G4FEV/SDRUno-Smart-Switch/README.md

<meta name='keywords' content='G4FEV, SDRUno, SDRplay'>

# SDRuno SMART-SWITCH

## David Whitty G4FEV

<i>Last edit 25 August 2020.</i>

This software is given freely for non-commercial use with no guarantee given or implied.
SDRUno is a product of SDRPlay Ltd with which the author has no connection other than as a satisfied customer.

<a href="https://github.com/G4FEV/SDRUno-Smart-Switch/archive/master.zip"><font size="2"> DOWNLOAD SMART-SWITCH PROJECT as zip</font></a>

## What is this?

An Arduino is used to detect the frequency SDRuno is tuned to.
The frequency is decoded and activates up to 14 outputs to automatically select antennas, filters or amplifiers as required for your particular application.

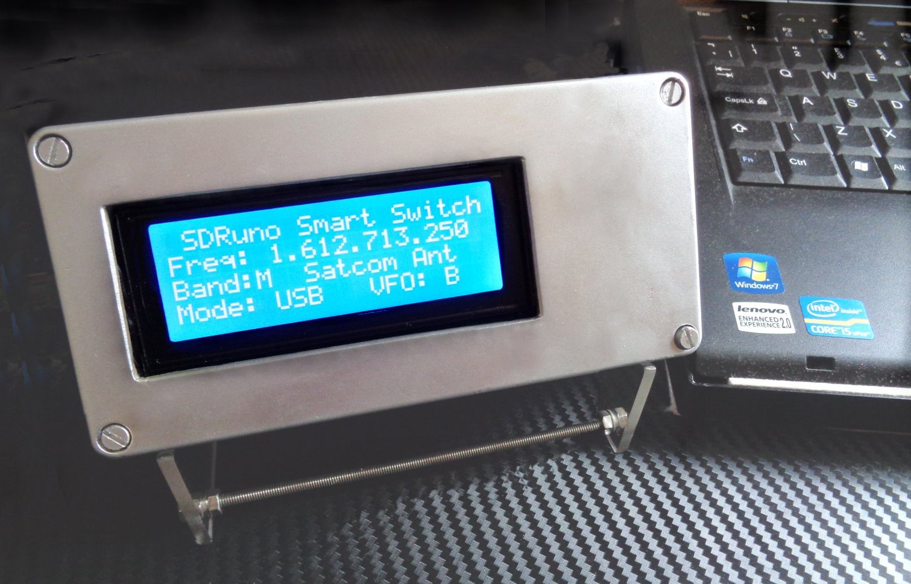
[picture p1: Images/sswitch1a.jpg]
<P ALIGN="CENTER">

## How does it work?

SDRuno uses commands from the Kenwood CAT command set.
The Arduino sends the    IF;    Status request to an SDRuno VRX. 
SDRuno responds with;-

     IF0145500000   +00000000002100000; 
           |                   ||
        145.500 MHz           |  | VFO
                              |	
                             Mode  

The Arduino has 14 unused pins (If we include unused Analogue pins) which may all be used for switching relays to swap antennas, filters or amplifiers.

## Does it compile?

Beware! There are several versions of  SoftwareSerial and Liquidcrystal I2c libraries which may not be compatible without minor changes to the declarations.

Built & tested using Arduino IDE Version 1.8.13

SoftwareSerial from Arduino IDE Version 1.8.13

LiquidCrystal     I2C-1.1.2     by Frank de Brabander

SDRUno Version 1.33 and 1.40.1

SDRplay RSP1A (Because that’s all I have).

We use the SoftwareSerial library for the coms to SDRuno. 
Pin 8 is Rxd and 9 Txd which leaves the normal Arduino coms port for debugging information via the IDE Serial Monitor.

## Hardware Requirements.

<b>FTDI USB to SERIAL converter</b>

The Arduino requires TTL levels (5v) but a computer uses RS232 levels. Never connect a computer directly to an Arduino or damage may occur.
RS232 to TTL converters are easily and cheaply available online.            

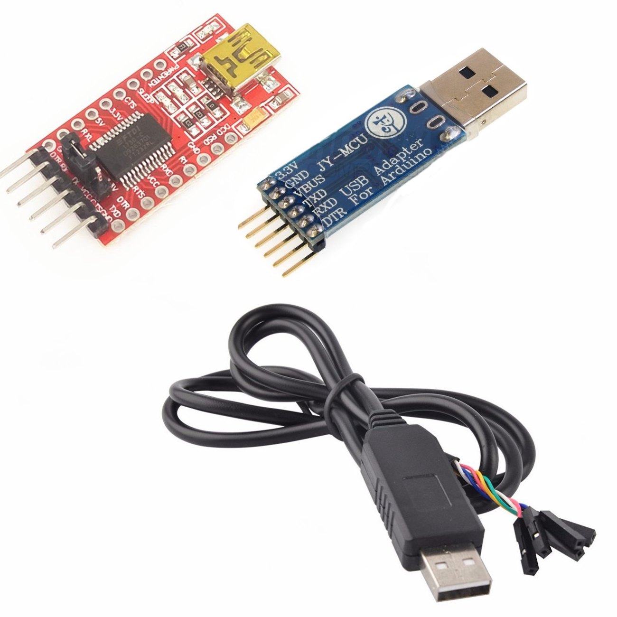
[picture p2: Images/ftdiall.jpg]
<P ALIGN="CENTER">
<P ALIGN="LEFT">
<B> RELAYS </B>

The maximum current an Arduino pin can switch is 40mA so we use a transistor to switch coax relays or slave relays.

If you choose to use the Ready mounted Arduino relays available on auction sites "CAUTION". Many of these are Active LOW. 
The code is designed for ACTIVE HIGH.
You could swap all the Hi and lows but it would mean most of your relays would be operated all the time.
If you decide to use these Ready-Made Relay Boards look for the type with a jumper that can be set ACTIVE HI.

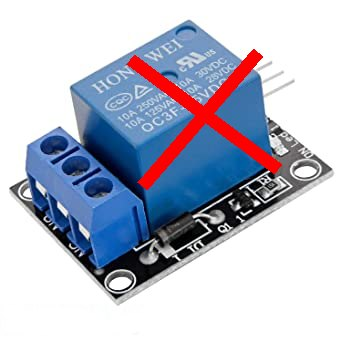
[picture p3: Images/relayno.jpg]
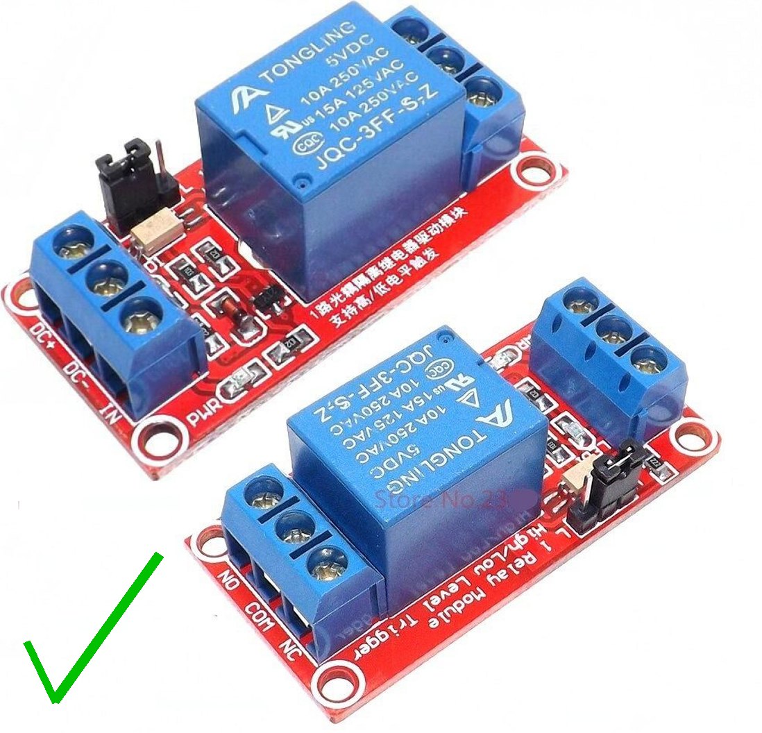
[picture p4: Images/relayyes.jpg]
<P ALIGN="LEFT">   
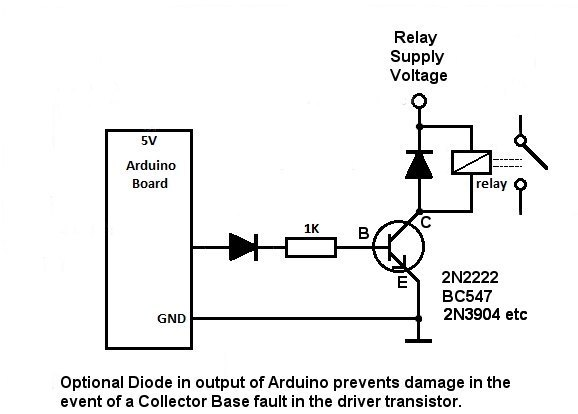
[picture p5: Images/relaycct2.jpg]
 

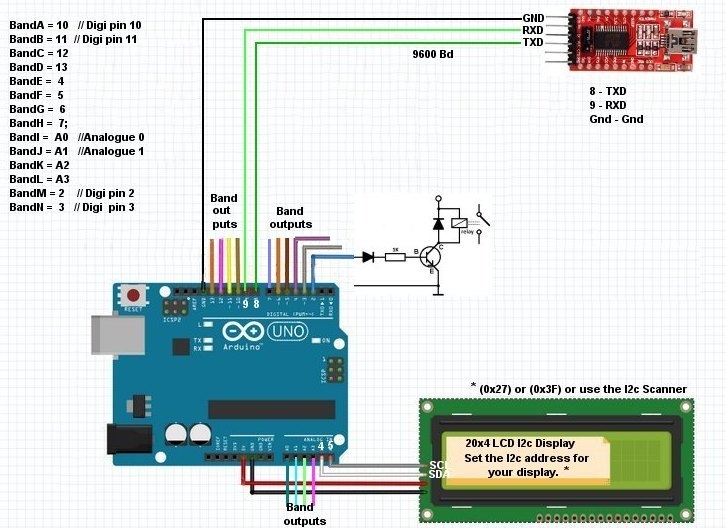
[picture p6: Images/Schematic1.jpg]
<P ALIGN="CENTER">

## SOFTWARE

Set the correct I2c address for your LCD I2c or you will just see a blank screen. (0x27) for older displays (0x3F) for newer displays or use the Arduino I2c scanner to discover the address.

<B>Setting the Band Limits</B>

Modify this part of the code to suit your application, located near the top of the sketch.
You may edit the frequencies and the Antenna / Filter name.
Shown below are the first three, of 14, Bands

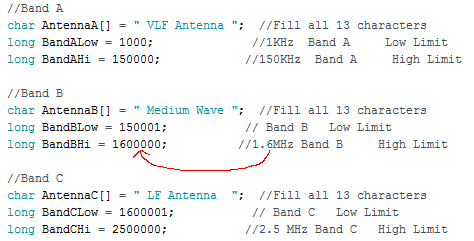
[picture p7: Images/Code1.png]
<P ALIGN="LEFT">
     
Notice how the next band up starts one Hertz above the last band.
The bands don’t have to run contiguously. This is just an example.

<B>SUGGESTION.</B>

* Run the code unmodified using LEDs on the Band Outputs and see how they react to frequency changes before you modify for your own requirements. 

* You don’t have to use all the outputs just park them out of the way near the 2GHz (or 1KHz) end of the spectrum so they never operate or comment them out.

* Take care as you move higher up in the spectrum. There are lots of zeroooos to trip over. It’s easy to get in a right old mess. (I speak from experience!)

Serial.print debug messages have been commented-out, apart from the current Frequency.

Uncommenting the remaining Serial.print messages will allow the user to monitor the decoding process the results of which may be viewed on the serial monitor as the program runs. Remember to Re-comment Serial.print messages when you are finished and the code will run slightly faster.

## SETTING UP SDRUno

Plug in your USB to FTDI-TTL converter and note its Com port. On Windows find this in <i><b> Devices and Printers.</i></b>

Top Left corner of theSDRUno <b> RX Control window </b> click the<b> SETT</b> button. Navigate along to the <b>CAT</b> option.

Select the com port and set the Baud Rate to 9600. Select <B> Enable & Connect.</B>

That’s it. 

If all is well the Smart-Switch LCD display should change from <B>“Waiting for data”</B>

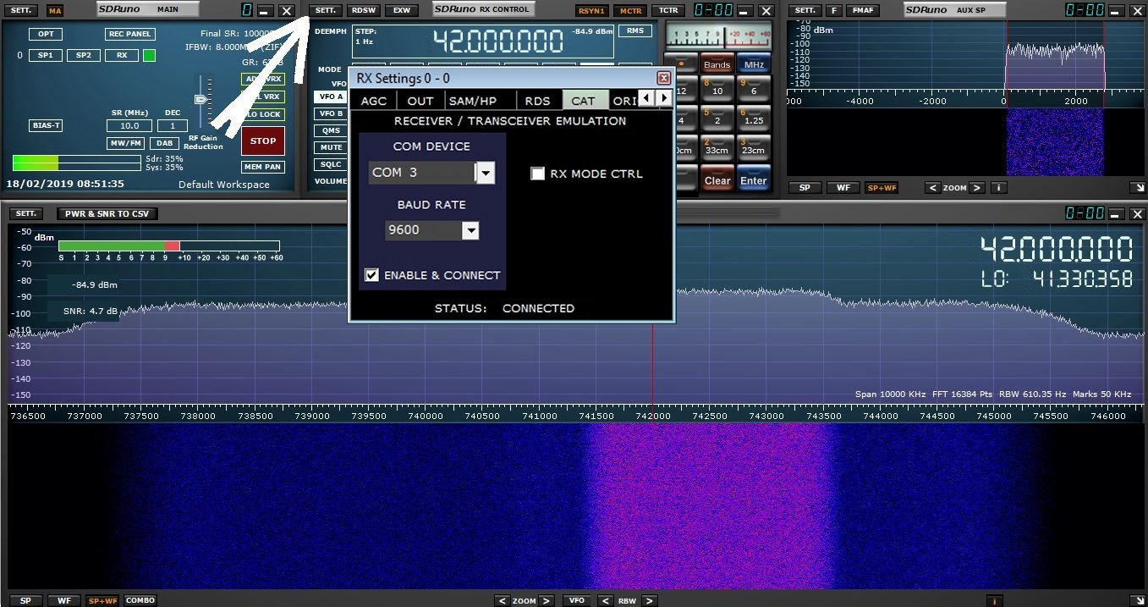
[picture p8: Images/Capture2.jpg]
<P ALIGN="CENTER">

## Notes.

* <b>Multi VRX setups.</b> 
You can use as many Smart-Switches as you like and allocate a Smart-Switch to each VRX. Just set the com port for each individual Smart-Switch to the VRX as above.

* <b> Scanning.</b> It may be unwise to switch antennas while scanning. Ensure your scanning frequencies are all on one band for optimum performance. It will work however the switching time may cause signals to be lost during the changeover period.

* <b>Error message on starting SDRUno.</b> If you start SDRUno before connecting the FTDI USB converter it will throw up this error. It's no big deal, just go into the VRX <b>SETT</b> and toggle the <b>CAT</b> setting <b>ENABLE & CONNECT</b>

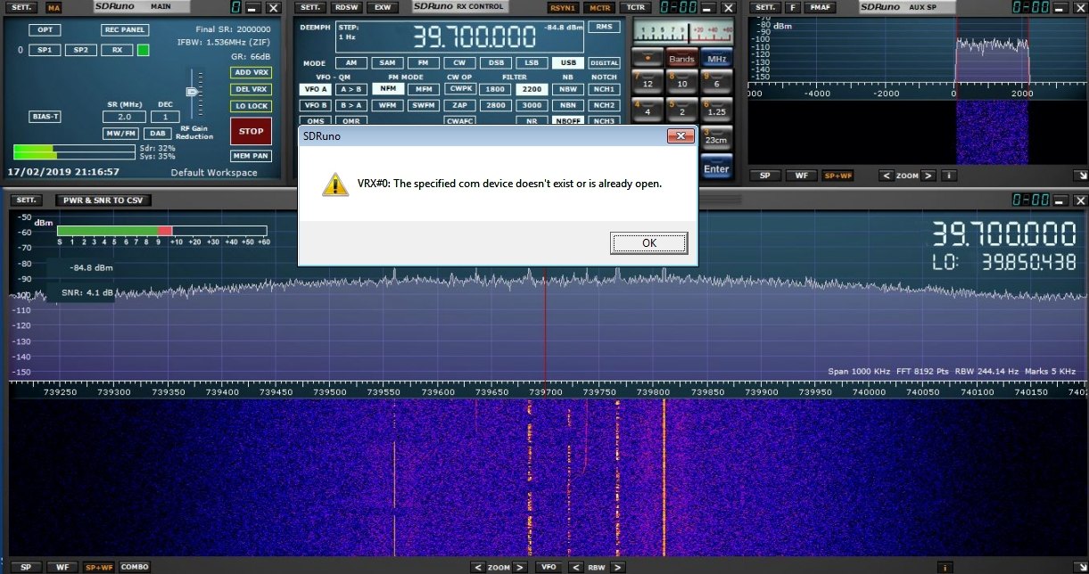
[picture p9: Images/Capture1.JPG]
<P ALIGN="CENTER">

* <b>LCD Blank Screen.</b>
Have you set the correct I2c address for your LCD. These are normally  0x3F or 0xFF or even 0x27 if you have an older display.
Use the Arduino I2c scanner sketch to confirm your address and the Hello World example to check it works

* <b>Serial.print messages.</b>
If you uncomment ALL the Serial.print messages the code will run slower and a warning will appear when compiling;-      
<P ALIGN="CENTER"><B><i>Low dynamic memory warning 78% may cause instability</B></i>

Remember to re-comment these before final use for optimum performance.

## Practical Application

For antenna switching I use a 6 Way SMA relay configured for Bands A to F. The display unit is connected to the relay box located under the bench. 
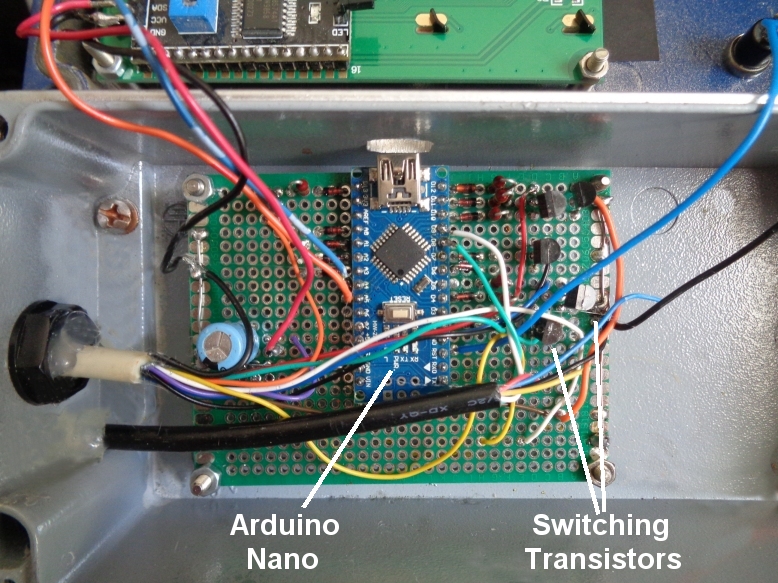
[picture p10: Images/zsc001.JPG]
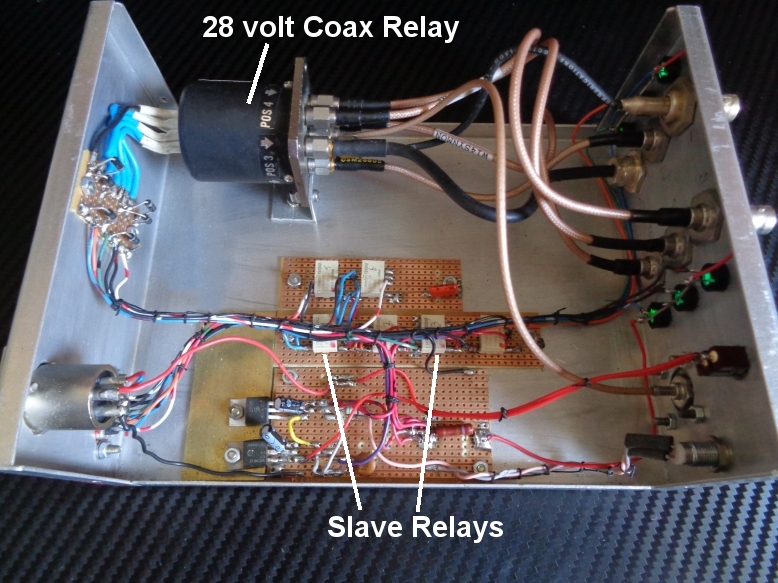
[picture p11: Images/zsc002.JPG]
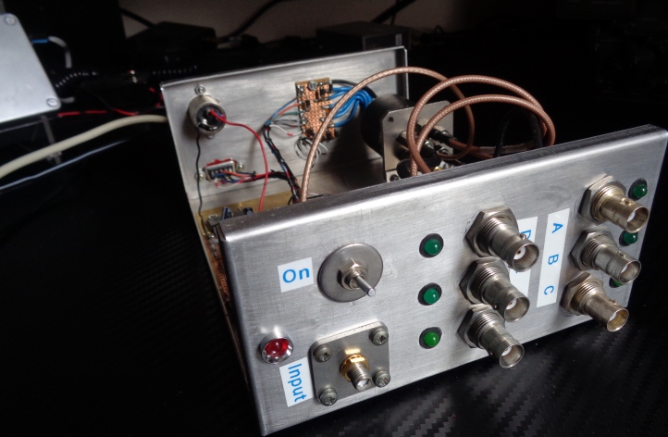
[picture p12: Images/zsc003a.jpg]
<P ALIGN="LEFT">    

That's all folks. 73 de Dave G4FEV.
